Hansolo2r/stm32-transport-logger/docs/mobile-app/desktop-overview.png

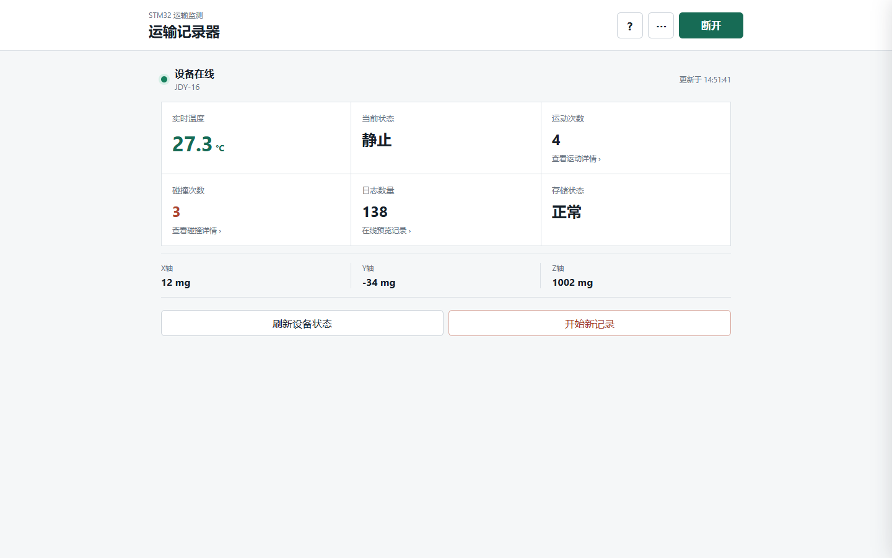
docs/mobile-app/desktop-overview.png
