Hansolo2r/stm32-transport-logger/docs/mobile-app/desktop-rtc-records.png

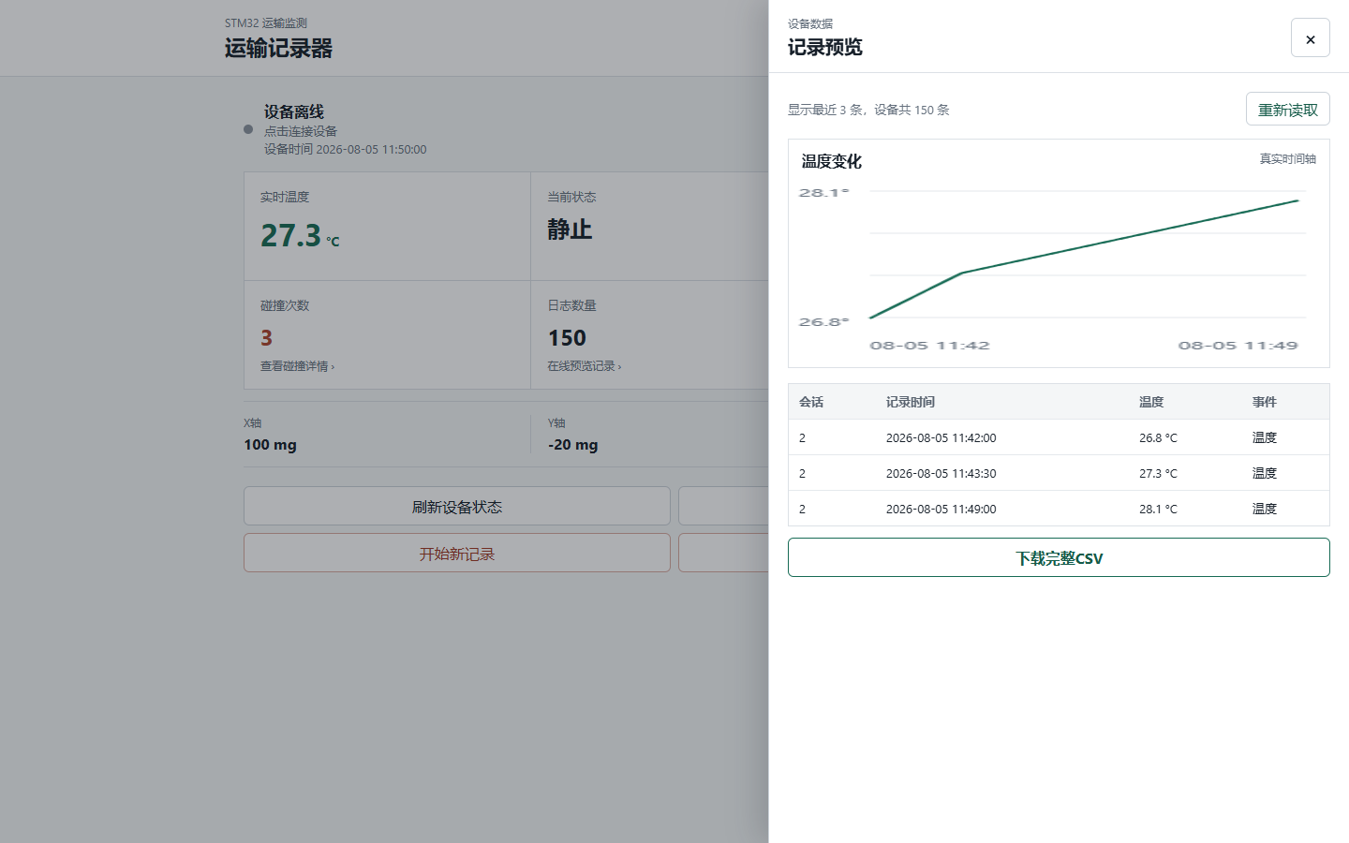
docs/mobile-app/desktop-rtc-records.png
