Hansolo2r/stm32-transport-logger/docs/mobile-app/mobile-controls.png

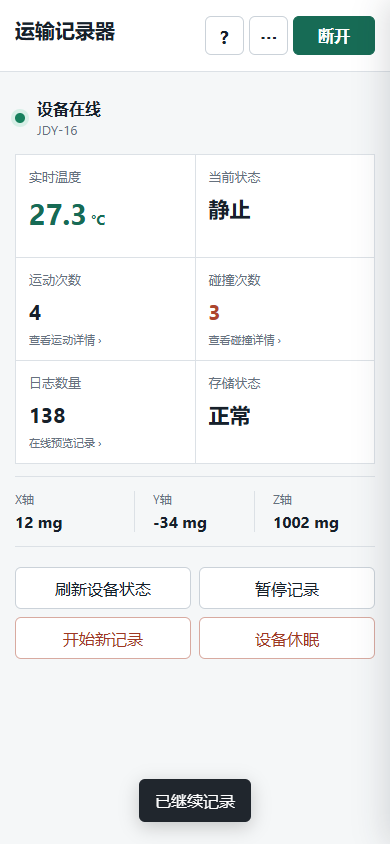
docs/mobile-app/mobile-controls.png
