Hansolo2r/stm32-transport-logger/docs/mobile-app/mobile-overview.png

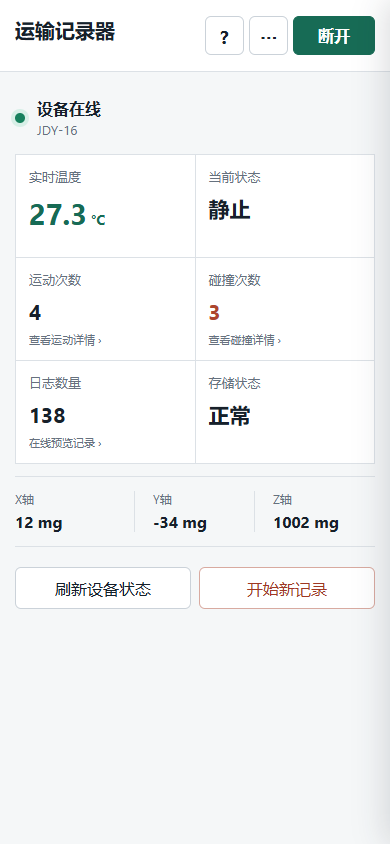
docs/mobile-app/mobile-overview.png
