Hansolo2r/stm32-transport-logger/docs/mobile-app/mobile-records.png

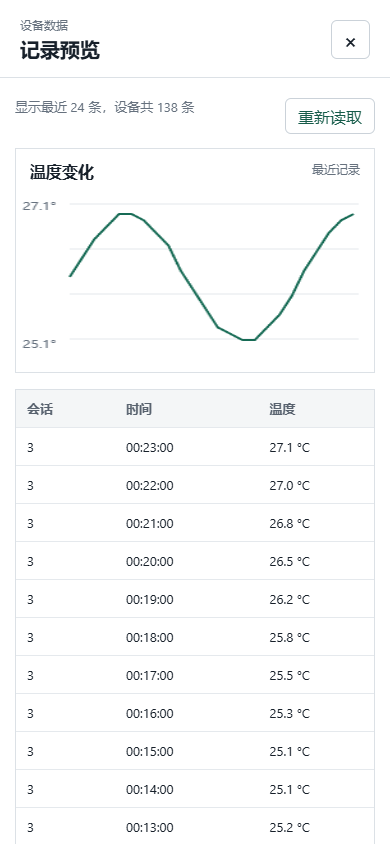
docs/mobile-app/mobile-records.png
