Hansolo2r/stm32-transport-logger/docs/mobile-app/mobile-rtc-records.png

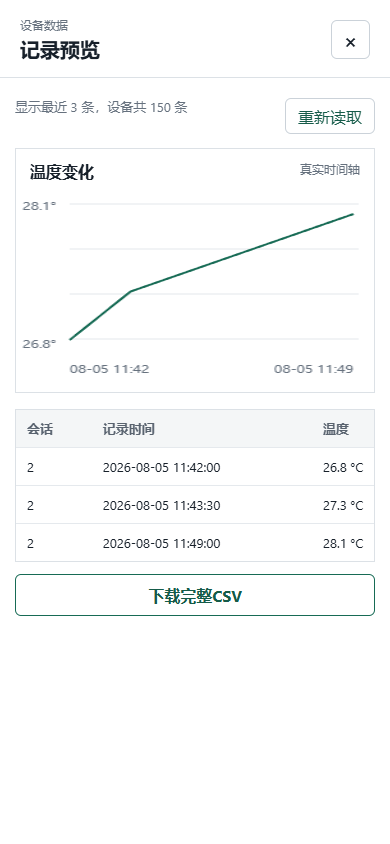
docs/mobile-app/mobile-rtc-records.png
