Hansolo2r/stm32-transport-logger/docs/mobile-app/mobile-shock.png

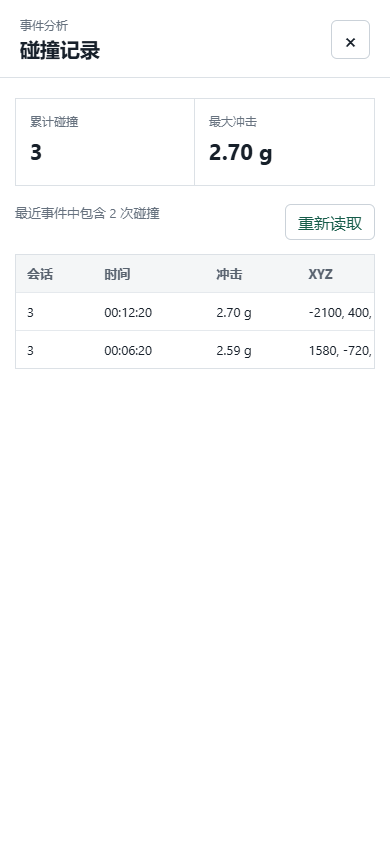
docs/mobile-app/mobile-shock.png
