Hansolo2r/stm32-transport-logger/docs/mobile-app/mobile-sleep-wake.png

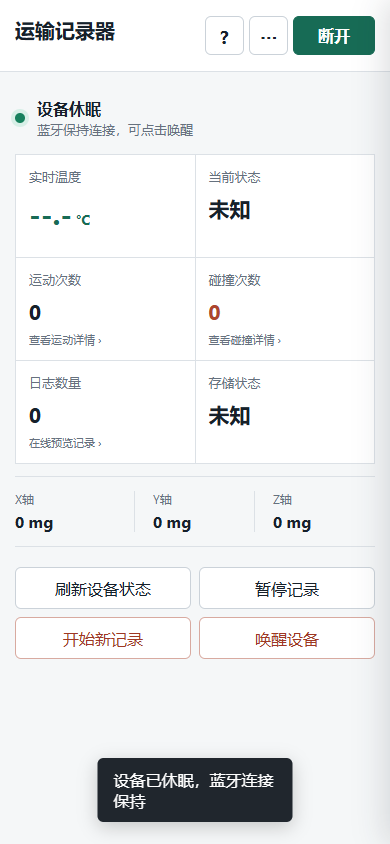
docs/mobile-app/mobile-sleep-wake.png
