Hansolo2r/stm32-transport-logger/docs/mobile-app/preview-desktop.png

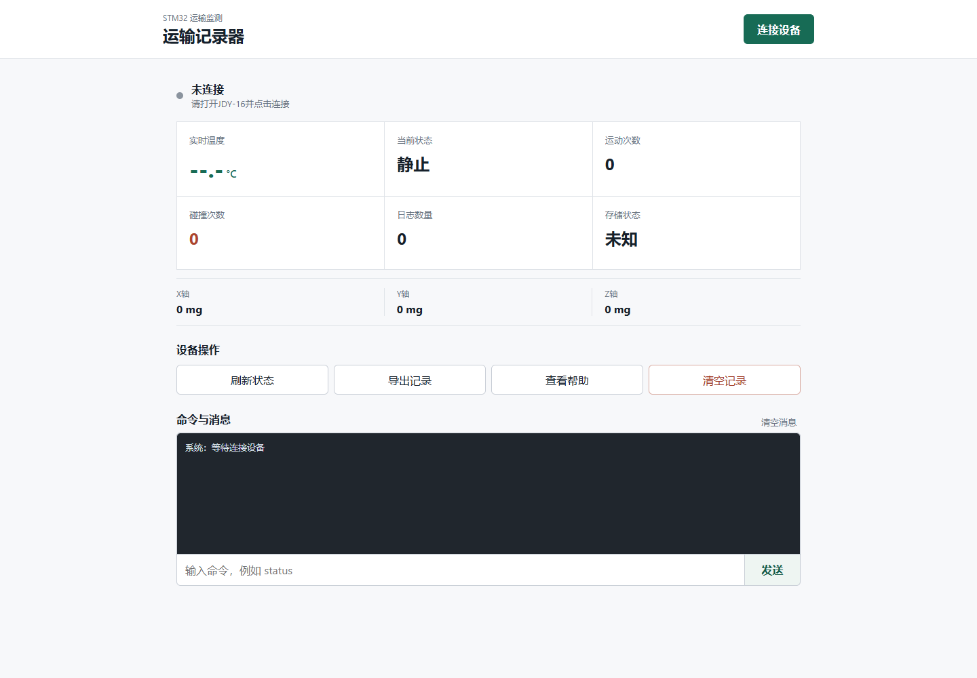
docs/mobile-app/preview-desktop.png
