Hansolo2r/stm32-transport-logger/docs/mobile-app/preview-mobile.png

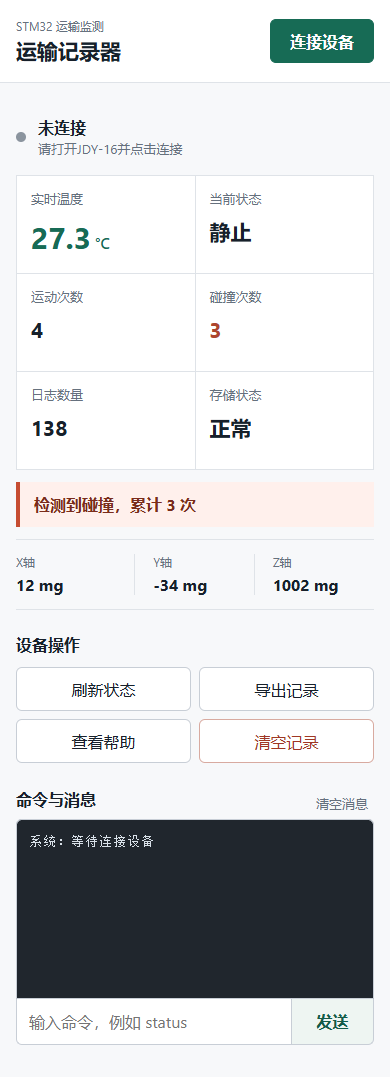
docs/mobile-app/preview-mobile.png
