Hansolo2r/stm32-transport-logger/docs/wiring/breadboard-wiring.png

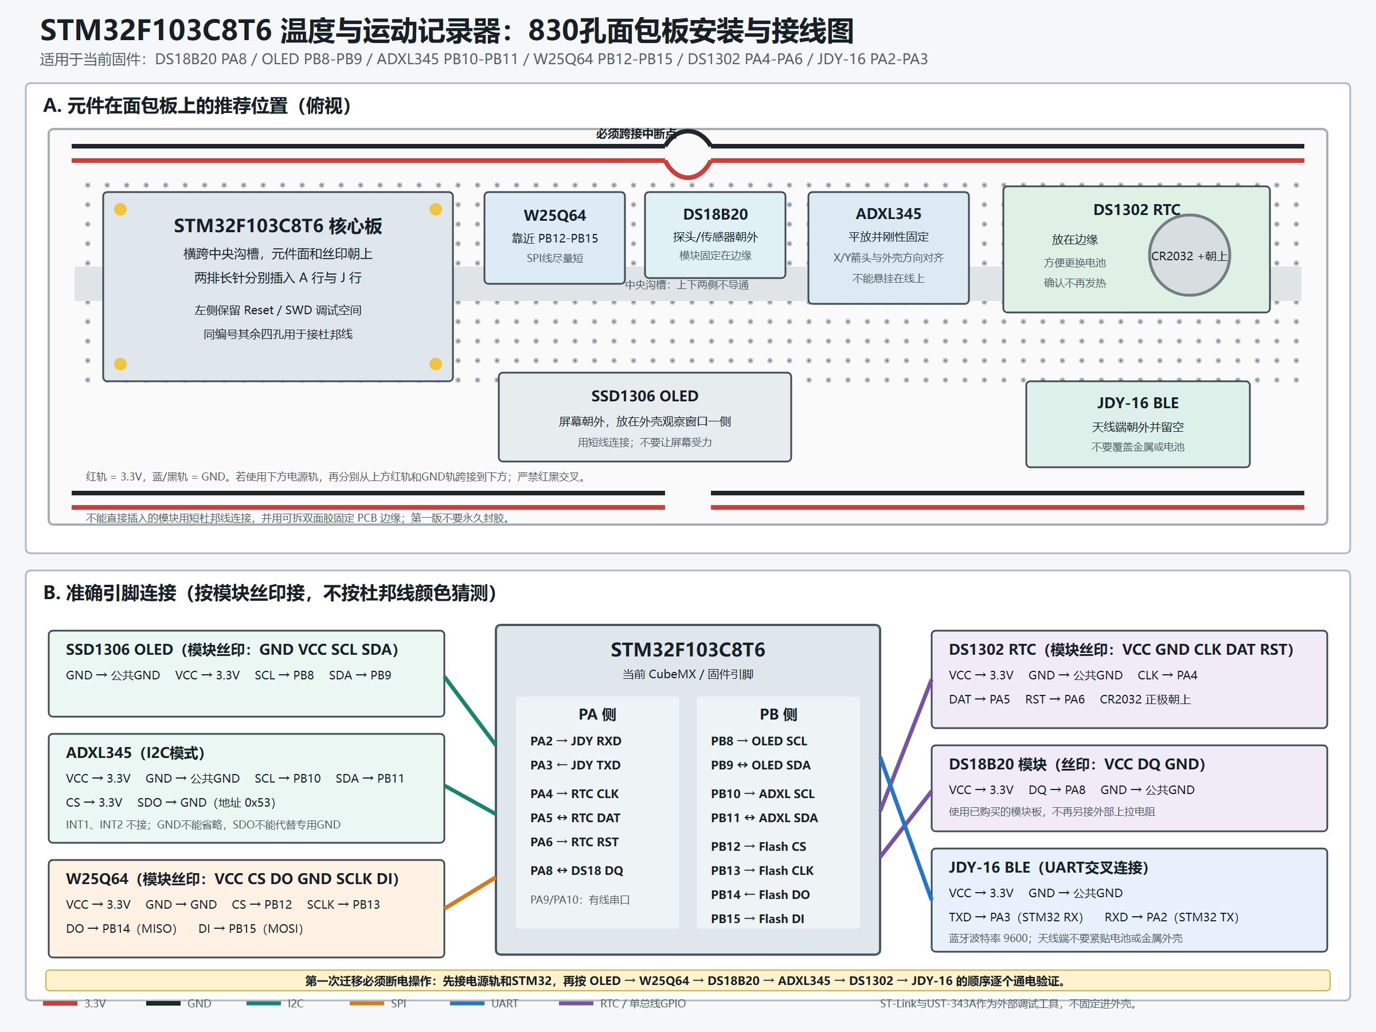
docs/wiring/breadboard-wiring.png
