Hansolo2r/stm32-transport-logger/docs/wiring/final-assembly-sequence.png

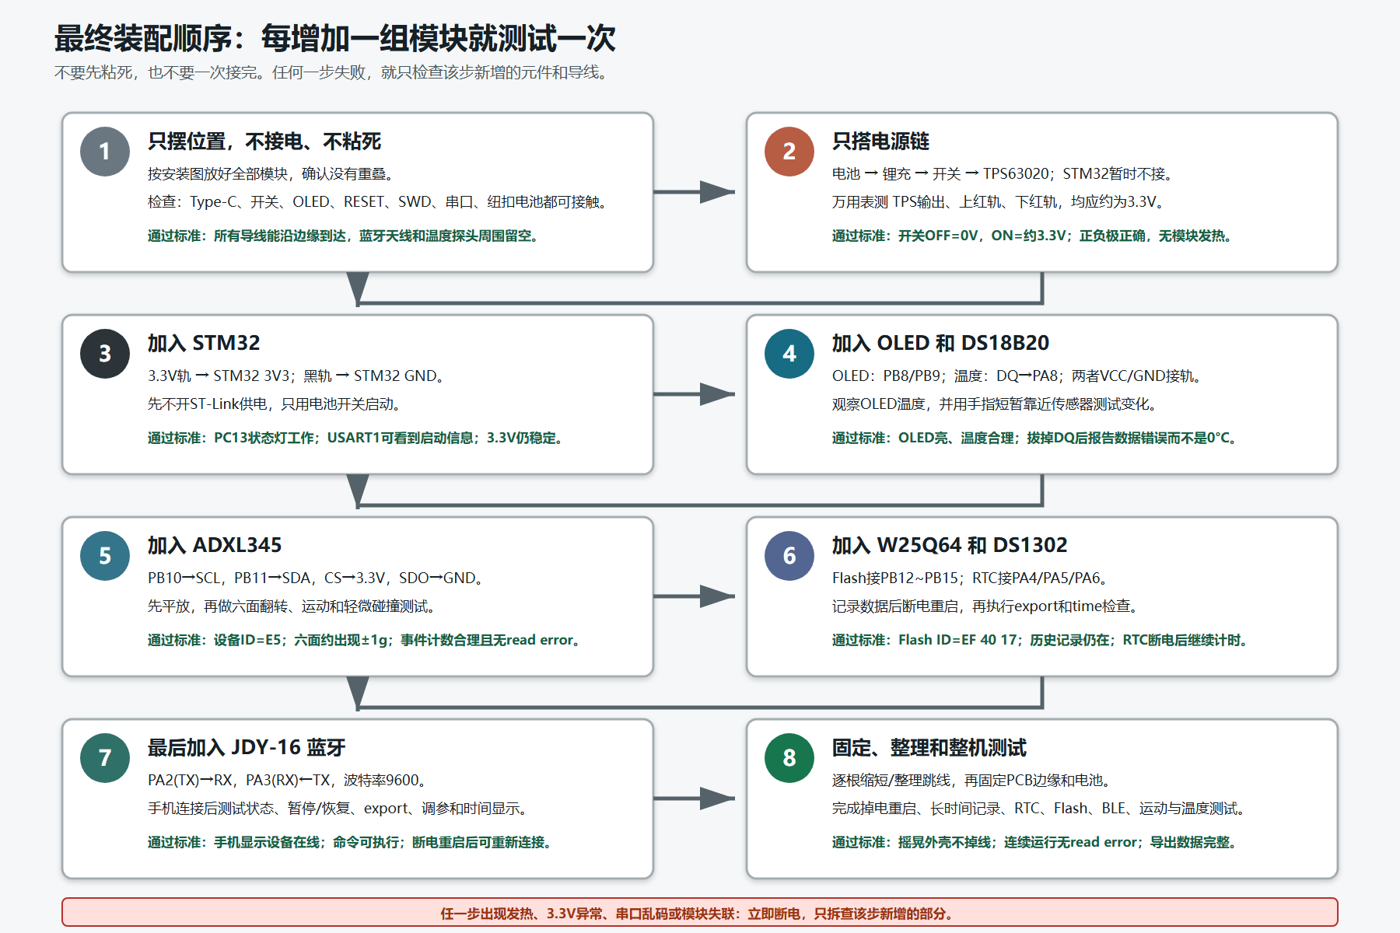
docs/wiring/final-assembly-sequence.png
