Hansolo2r/stm32-transport-logger/docs/wiring/final-breadboard-placement.png

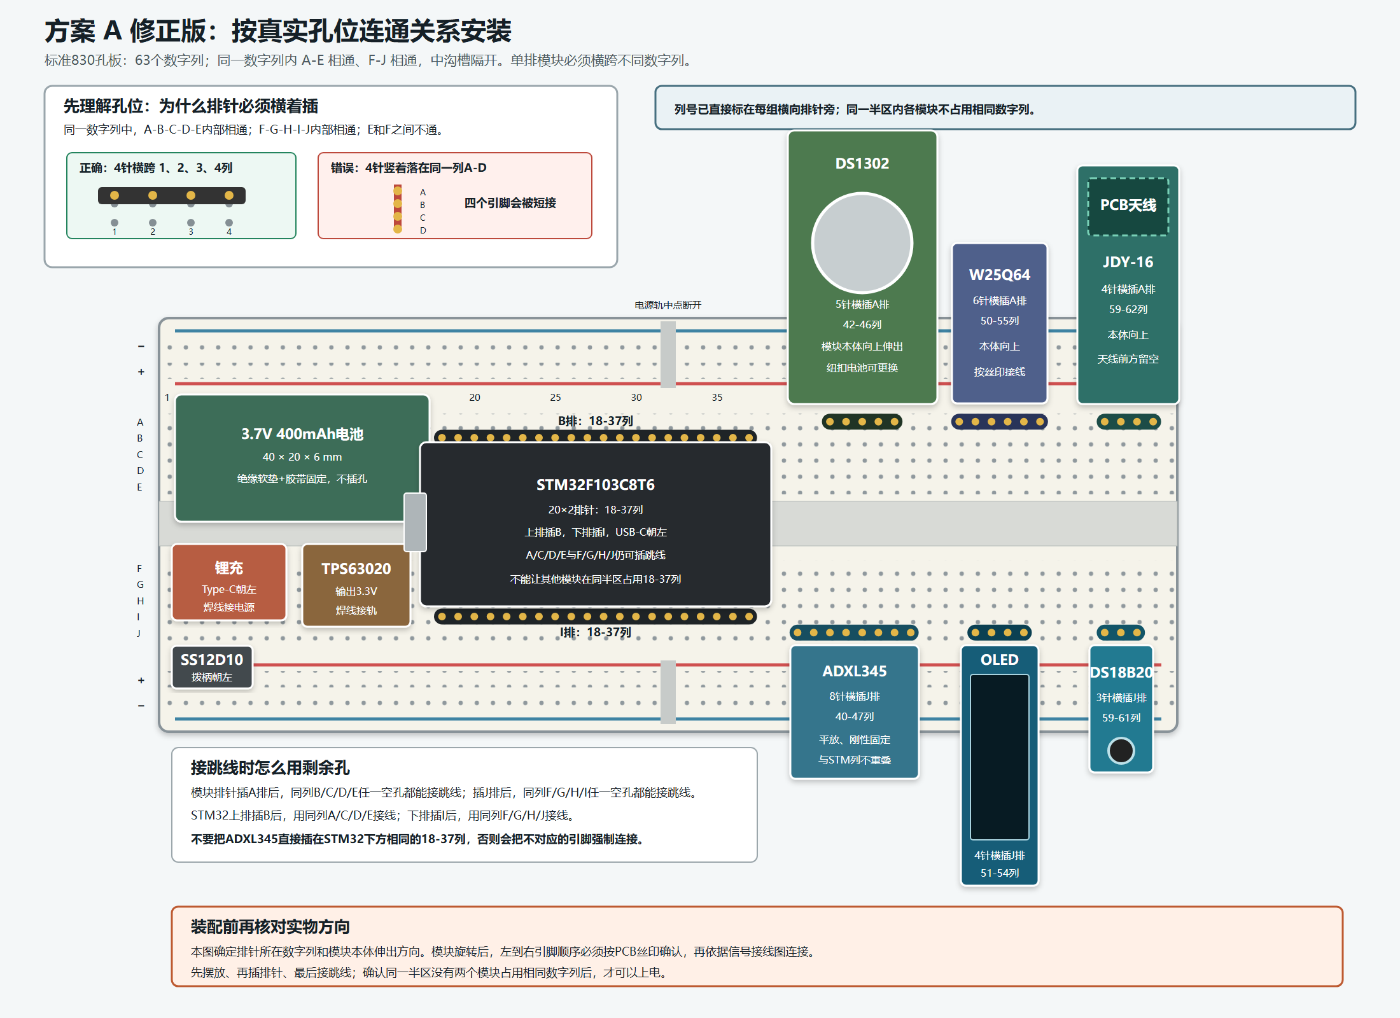
docs/wiring/final-breadboard-placement.png
