Hansolo2r/stm32-transport-logger/docs/wiring/final-power-wiring.png

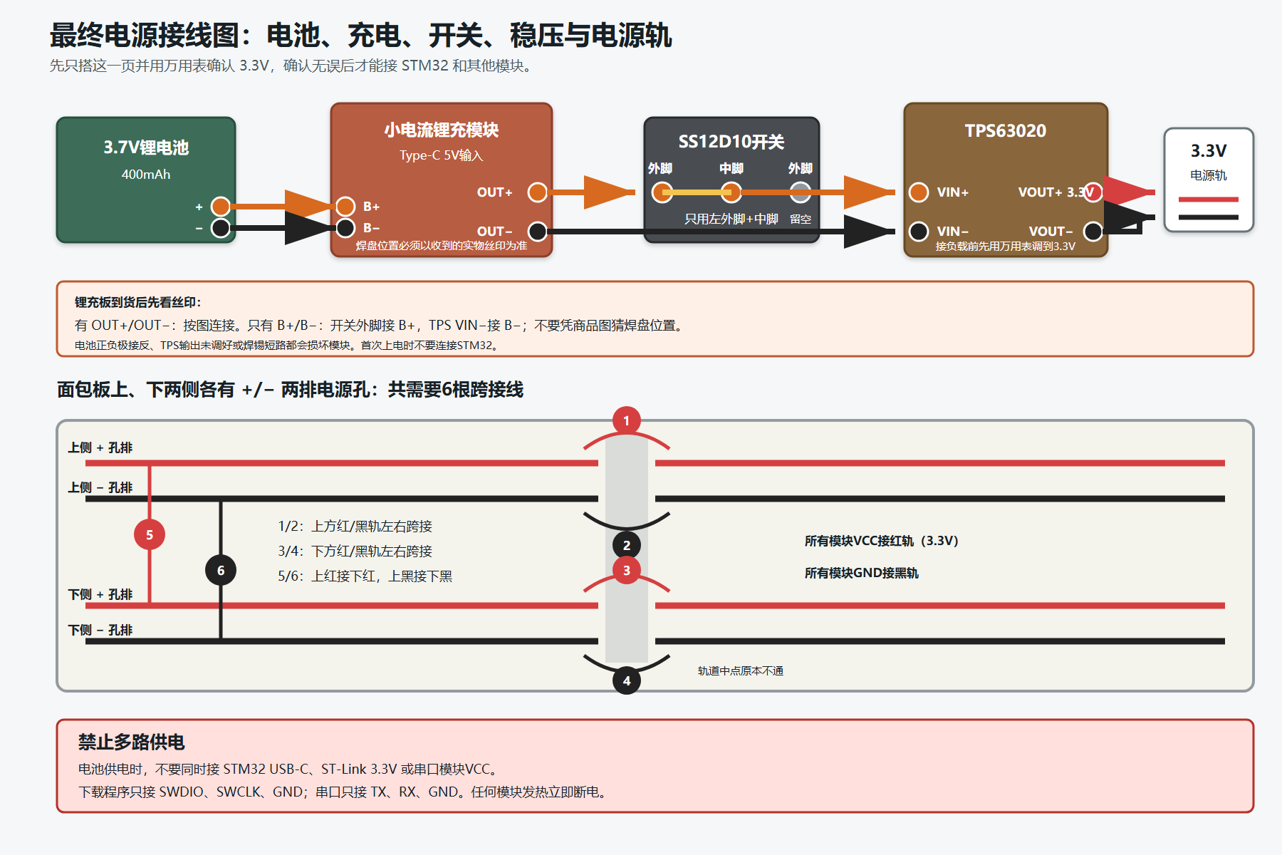
docs/wiring/final-power-wiring.png
