Hansolo2r/stm32-transport-logger/docs/wiring/final-signal-wiring.png

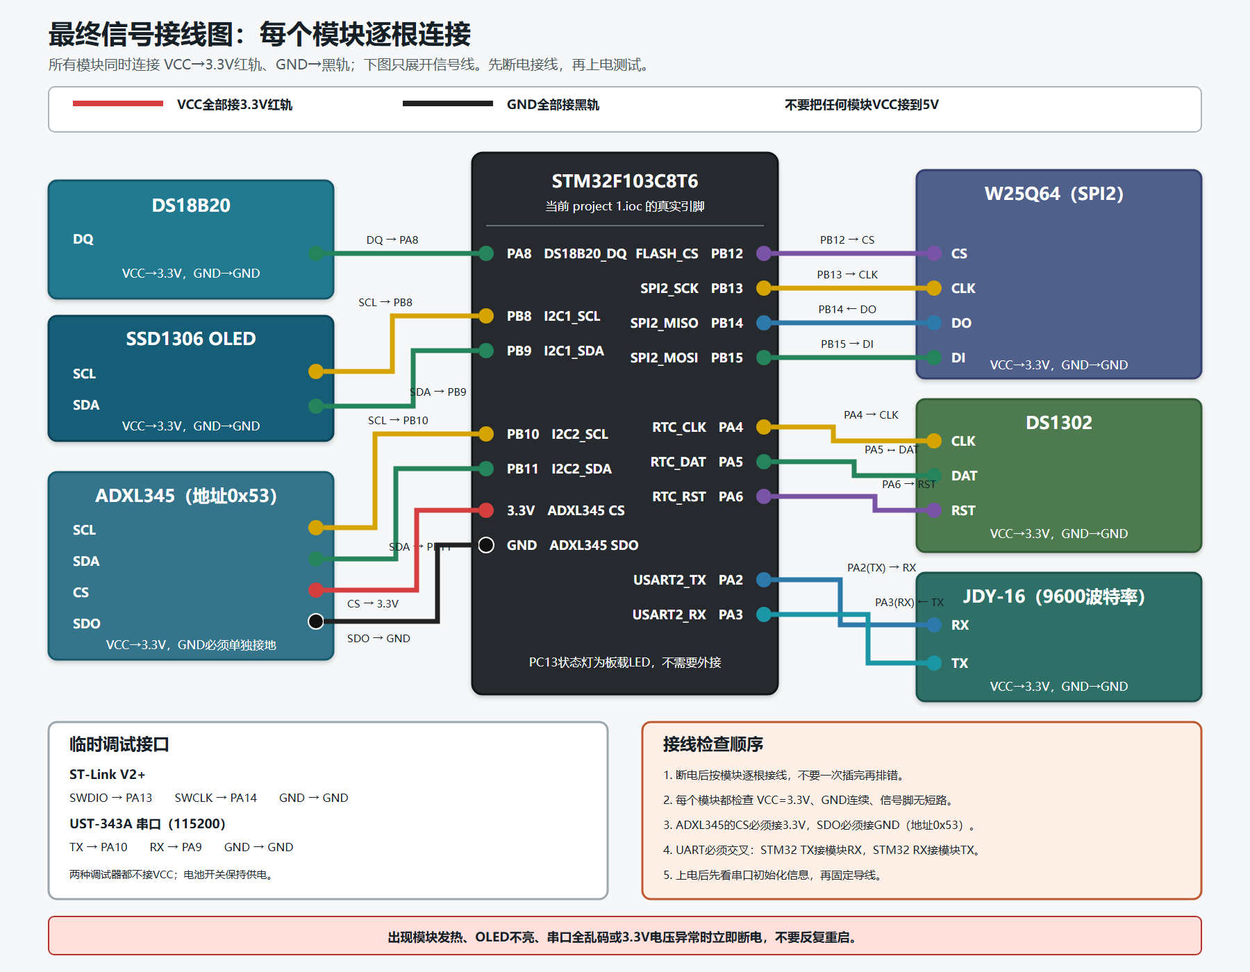
docs/wiring/final-signal-wiring.png
