Hansolo2r/stm32-transport-logger/CHANGELOG.md

# Changelog

## 2026-08-10

- Archived real serial exports and their validation notes.
- Documented the final hand-held motion and light-impact test boundary.
- Added a concise public project overview and reproducible test instructions.

## 2026-08-08

- Added configurable temporal motion and short-impact classification.
- Added three-axis motion evidence and noise-tolerant motion end detection.
- Added mobile RTC synchronization.

## 2026-08-05

- Added RTC timestamps, the BLE dashboard, GitHub Pages deployment, and
  breadboard assembly references.
