Hansolo2r/stm32-transport-logger/Core/Inc/main.h

#define STATUS_LED_Pin GPIO_PIN_13
#define STATUS_LED_GPIO_Port GPIOC
#define DS18B20_DQ_Pin GPIO_PIN_8
#define DS18B20_DQ_GPIO_Port GPIOA
#define RTC_CLK_Pin GPIO_PIN_4
#define RTC_CLK_GPIO_Port GPIOA
#define RTC_DAT_Pin GPIO_PIN_5
#define RTC_DAT_GPIO_Port GPIOA
#define RTC_RST_Pin GPIO_PIN_6
#define RTC_RST_GPIO_Port GPIOA
#define FLASH_CS_Pin GPIO_PIN_12
#define FLASH_CS_GPIO_Port GPIOB
