Hansolo2r/stm32-transport-logger/(commit log)

2026-08-05 Publish STM32 transport logger prototype
2026-08-05 Fix RTC labels on mixed temperature charts
2026-08-05 Add breadboard placement and wiring diagram
2026-08-05 Add final breadboard assembly diagrams
2026-08-05 Correct 830-hole breadboard row layout
2026-08-10 Complete STM32 transport logger prototype
    [2026-08-10-development-export-metadata.csv, 2026-08-10-serial-transport-log-raw.csv, 2026-08-10-serial-transport-log.csv, test-run-metadata-template.csv]
2026-08-10 Finalize prototype documentation
